MajdAzzamx1/Test1/WRO GitHub/V1/models/3D printers/Room.jpeg

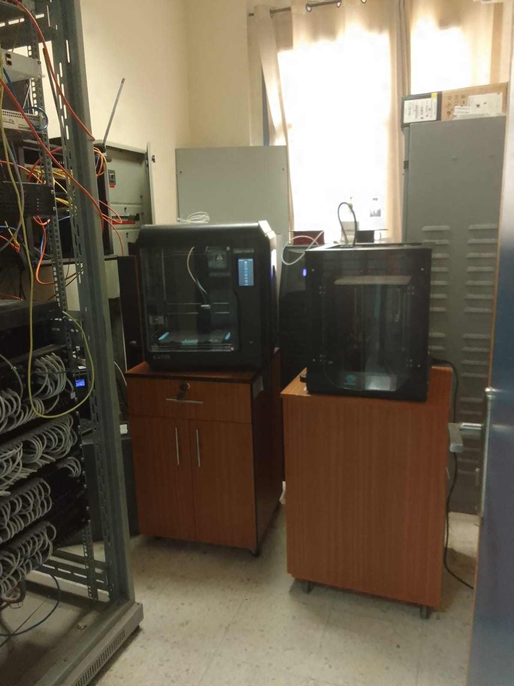
WRO GitHub/V1/models/3D printers/Room.jpeg
