MajdAzzamx1/Test1/WRO GitHub/V1/models/3D design/CASEAR Design.pdf

# CAESAR DESIGNING

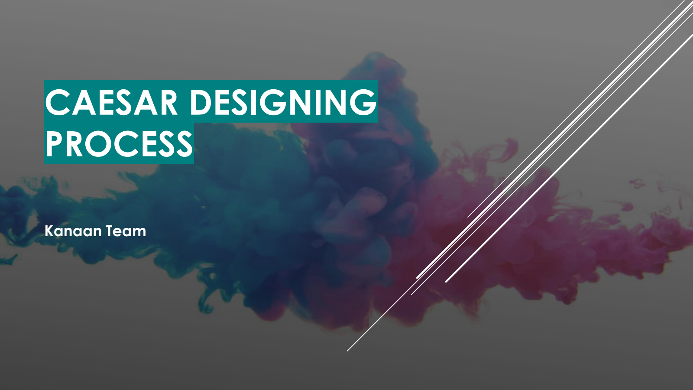
[picture p13: page 1]

# PROCESS

Kanaan Team

## DESIGN WORKFLOW

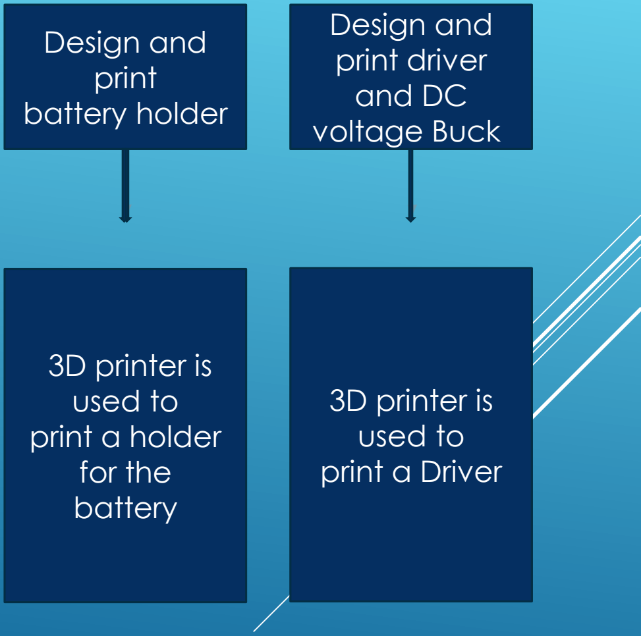
[picture p14: figure]
Design and print battery holder; Design and print driver and DC voltage Buck; 3D printer is used to print a holder for the battery; 3D printer is used to print a Driver

Design, build
and print the
robot structure

Design and
print camera
and Ultrasonic
holder

Design and
print Controller

3D printer is
used to
print a holder
for the
camera and
the front,
left, and right
ultrasonic
sensors.

3D printer is
used to
print a holder
for the
ESP32

The car's body
was built in
detail to hold
the DC motor
and the Servo
motor that
drives it

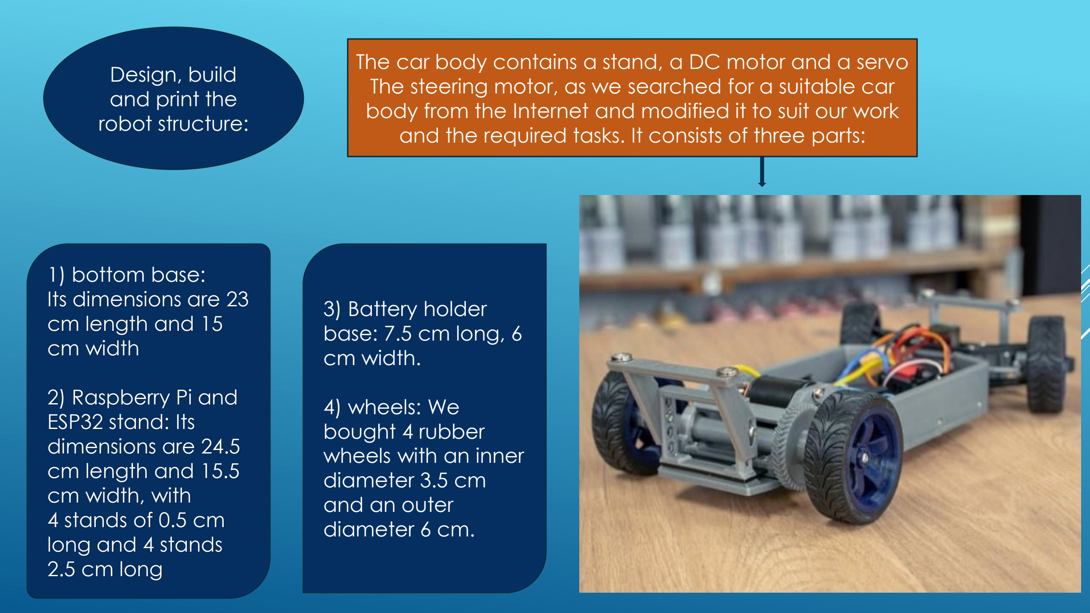
[picture p15: page 3]

Design, build
and print the
robot structure:

The car body contains a stand, a DC motor and a servo The steering motor, as we searched for a suitable car body from the Internet and modified it to suit our work and the required tasks. It consists of three parts:

1) bottom base:
Its dimensions are 23
cm length and 15
cm width
2) Raspberry Pi and
ESP32 stand: Its
dimensions are 24.5
cm length and 15.5
cm width, with
4 stands of 0.5 cm
long and 4 stands
2.5 cm long
3) Battery holder
base: 7.5 cm long, 6
cm width.
4) wheels: We
bought 4 rubber
wheels with an inner
diameter 3.5 cm
and an outer
diameter 6 cm.

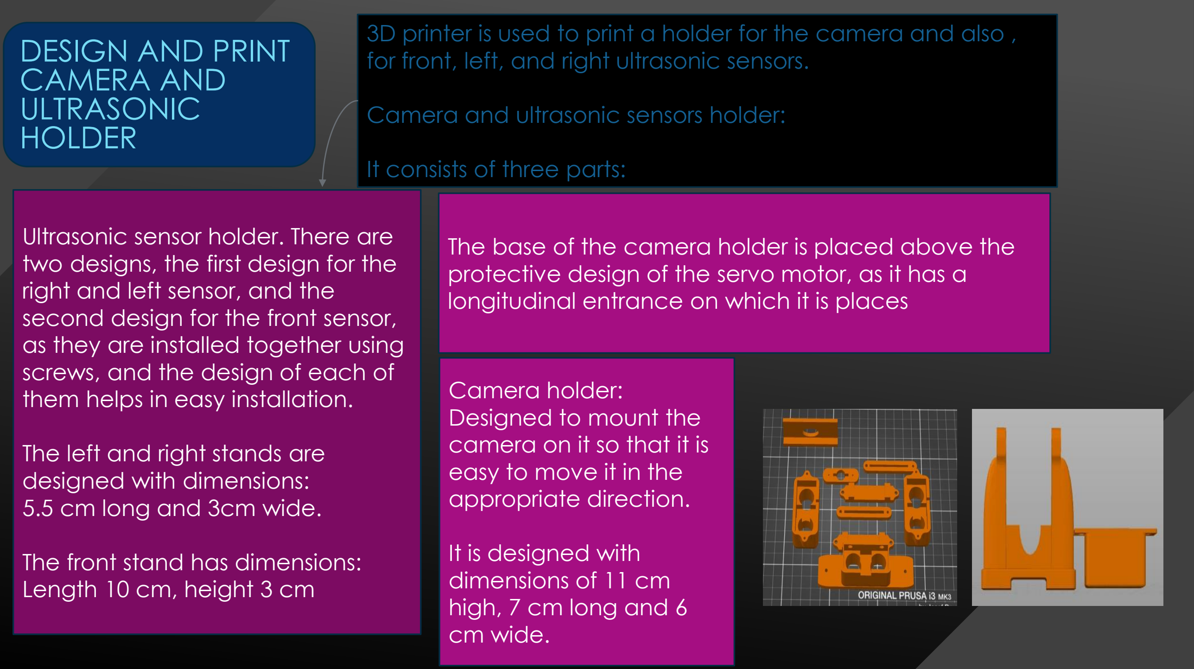
[picture p16: figure]
DESIGN AND PRINT CAMERA AND ULTRASONIC HOLDER; Camera and ultrasonic sensors holder:; It consists of three parts:; Ultrasonic sensor holder. There are two designs, the first design for the right and left sensor, and the second design for the front sensor, as they are installed together using screws, and the design of each of them helps in easy installation.; The left and right stands are designed with dimensions: 5.5 cm long and 3cm wide.; The front stand has dimensions: Length 10 cm, height 3 cm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

3D printer is used to print a holder for the camera and also , for front, left, and right ultrasonic sensors.

The base of the camera holder is placed above the protective design of the servo motor, as it has a longitudinal entrance on which it is places

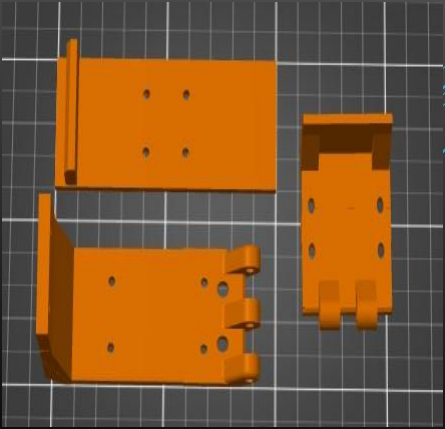
[picture p17: figure]

## DESIGN AND PRINT CONTROLLER

There is a piece on the base of the robot that contains a Raspberry Pi 4 controller, on top of which is a chassis-shaped pod that holds the Driver and ESP32.
above it. Its length is 9.5 and its width is 4.

ESP32 incubator dimensions: It is 8 cm long and 10 cm wide

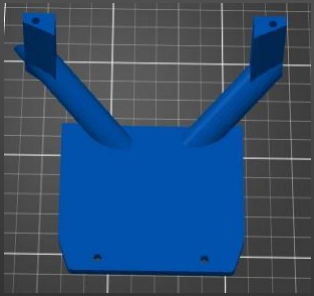
[picture p18: figure]
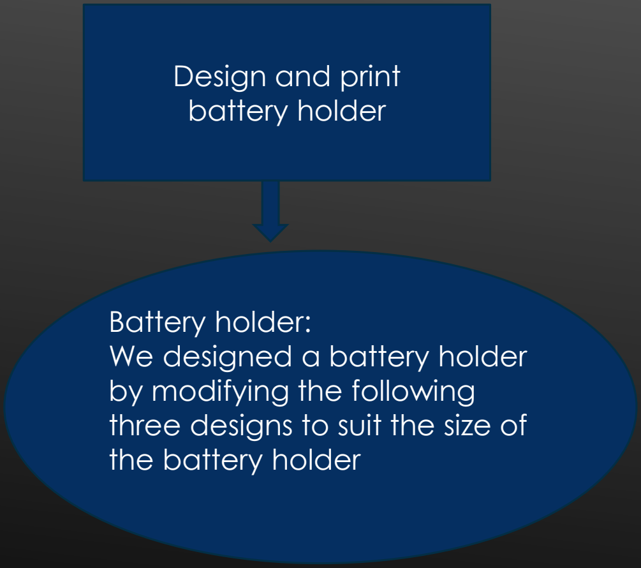
[picture p19: figure]
Design and print battery holder; Battery holder: We designed a battery holder by modifying the following three designs to suit the size of the battery holder
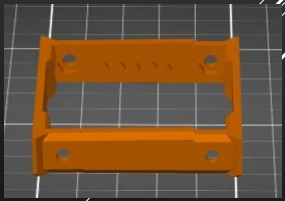
[picture p20: figure]

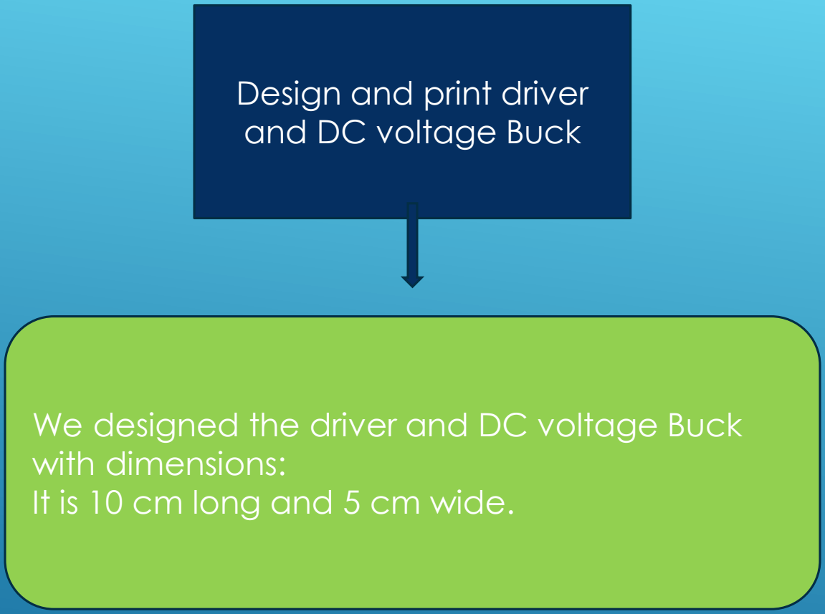
[picture p21: figure]
Design and print driver and DC voltage Buck; with dimensions: It is 10 cm long and 5 cm wide.
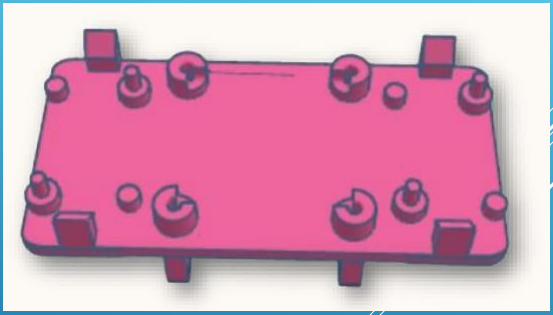
[picture p22: figure]

We designed the driver and DC voltage Buck

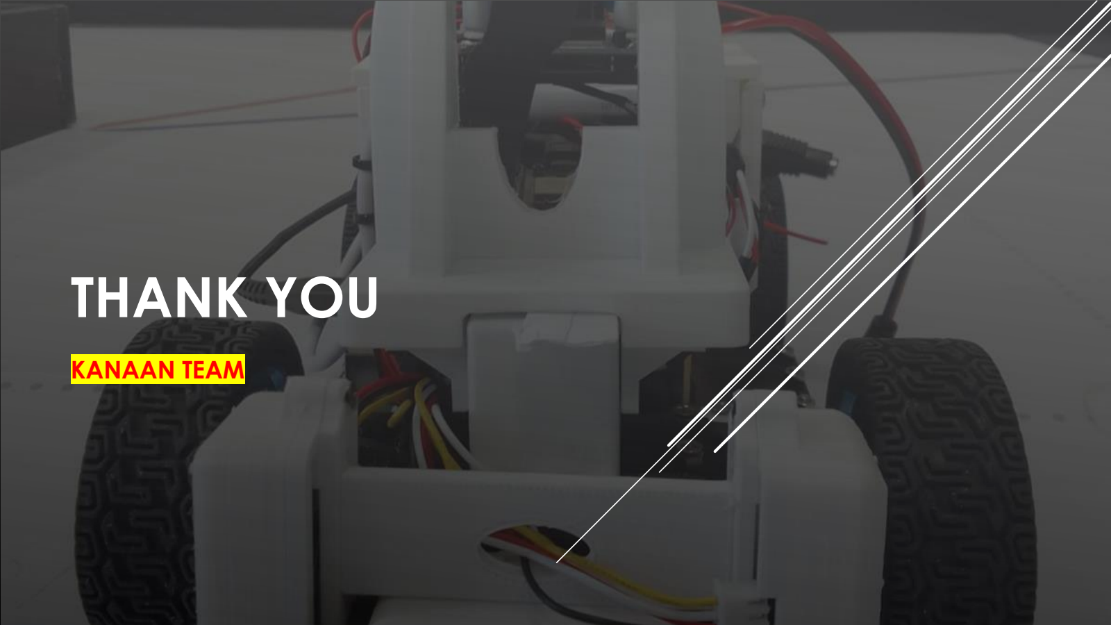
[picture p23: page 8]

# THANK YOU

KANAAN TEAM
