MajdAzzamx1/Test1/WRO GitHub/V1/schemes/Main Diagram.jpg

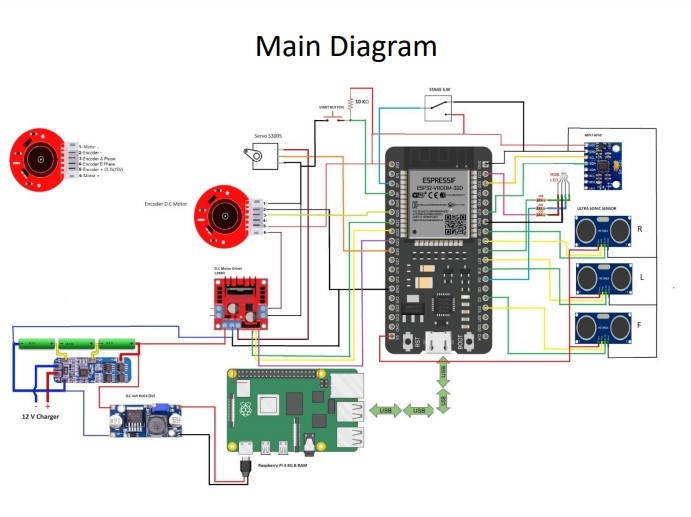
WRO GitHub/V1/schemes/Main Diagram.jpg
