MajdAzzamx1/Test1/WRO GitHub/V1/t-photo/Funny.jpeg

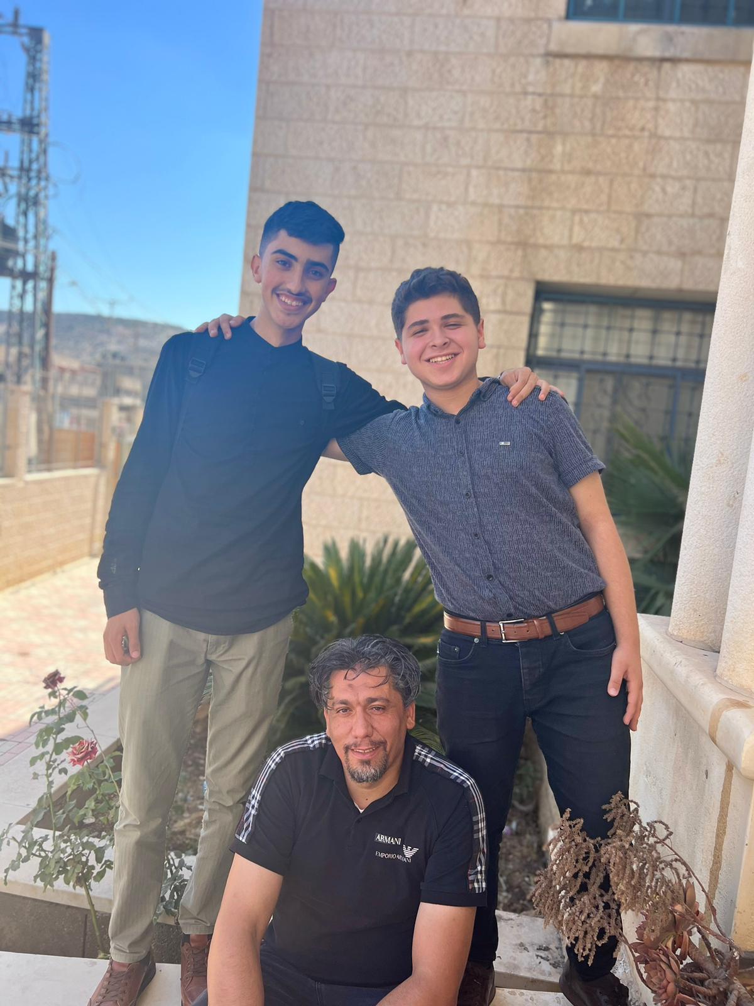
WRO GitHub/V1/t-photo/Funny.jpeg
