MajdAzzamx1/Test1/WRO GitHub/V1/t-photo/official.jpeg

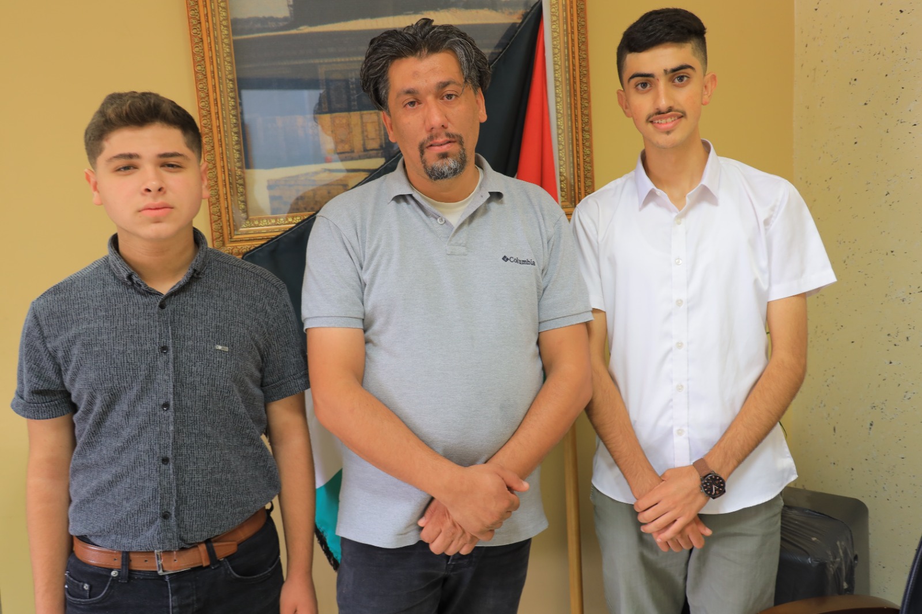
WRO GitHub/V1/t-photo/official.jpeg
