MajdAzzamx1/Test1/WRO GitHub/V1/v-photo/Back Side.jpeg

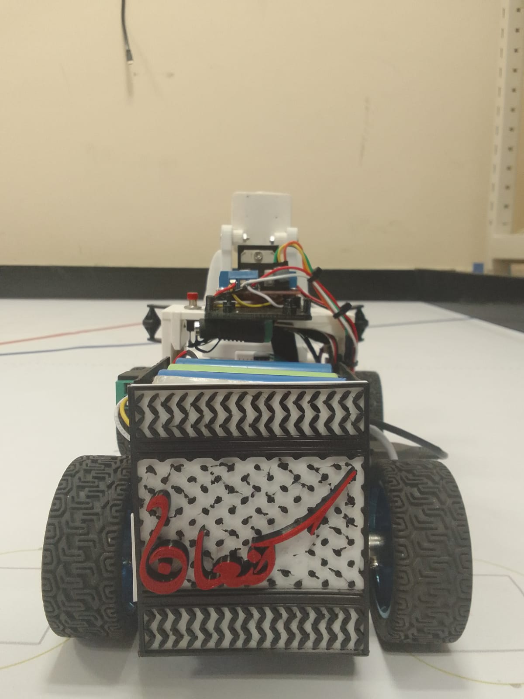
WRO GitHub/V1/v-photo/Back Side.jpeg
