MajdAzzamx1/Test1/WRO GitHub/V1/v-photo/Down Side.jpeg

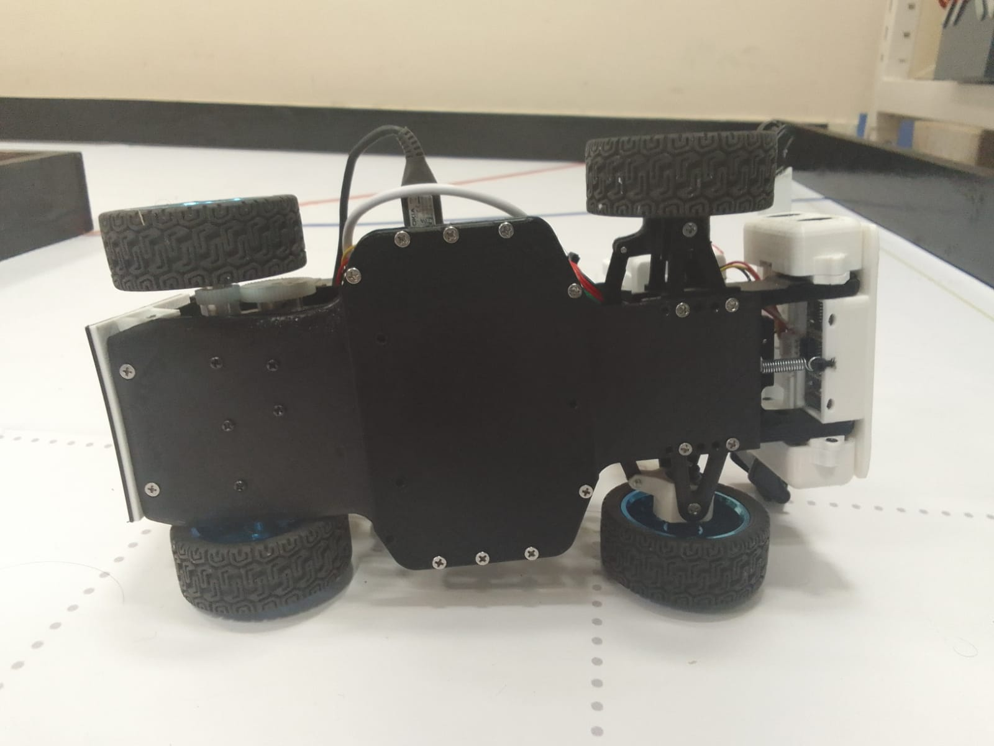
WRO GitHub/V1/v-photo/Down Side.jpeg
