MajdAzzamx1/Test1/WRO GitHub/V1/v-photo/Front Side.jpeg

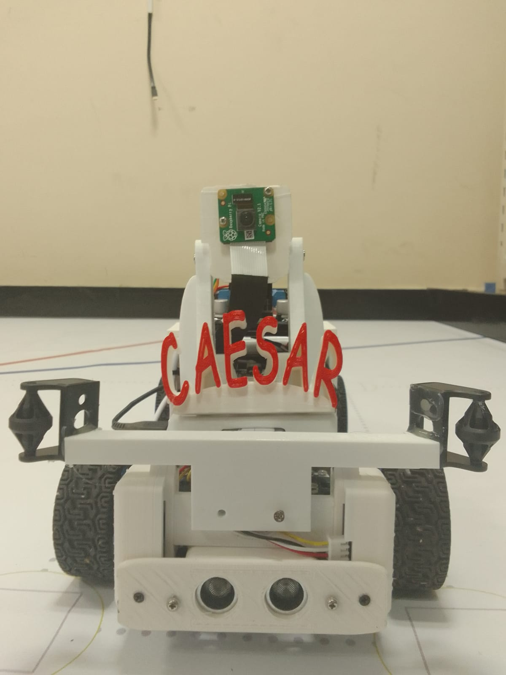
WRO GitHub/V1/v-photo/Front Side.jpeg
