MajdAzzamx1/Test1/WRO GitHub/V1/v-photo/Top Side/Top Side1.jpeg

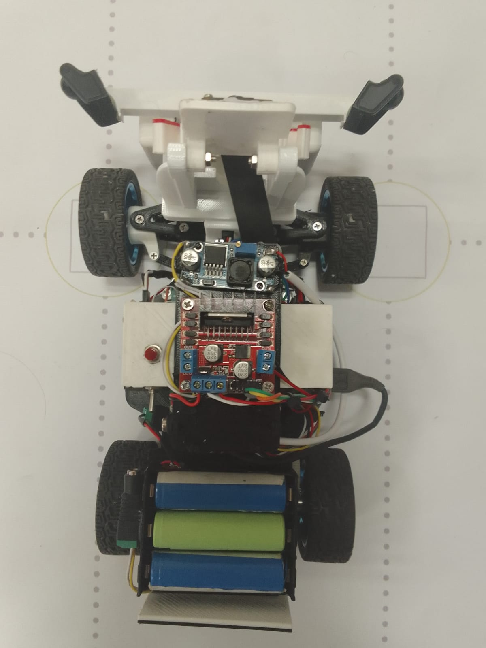
WRO GitHub/V1/v-photo/Top Side/Top Side1.jpeg
