MajdAzzamx1/Test1/WRO GitHub/3d/Rear_Flex_2.stl

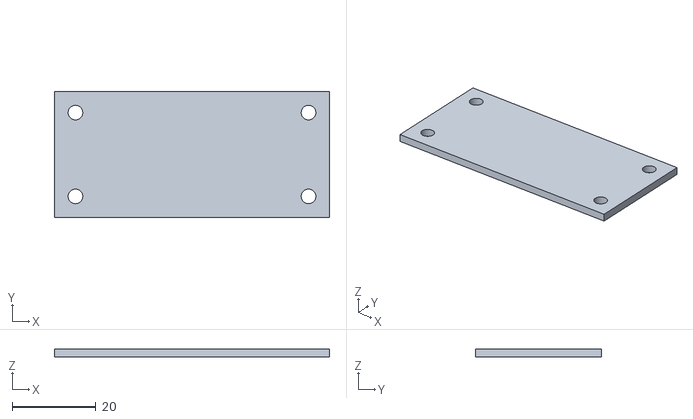
[picture p57: CAD file, 2023-10-11]
WRO GitHub/3d/Rear_Flex_2.stl
65.6 x 30.0 x 2.00
