MajdAzzamx1/Test1/WRO GitHub/3d/Chassis_1.stl

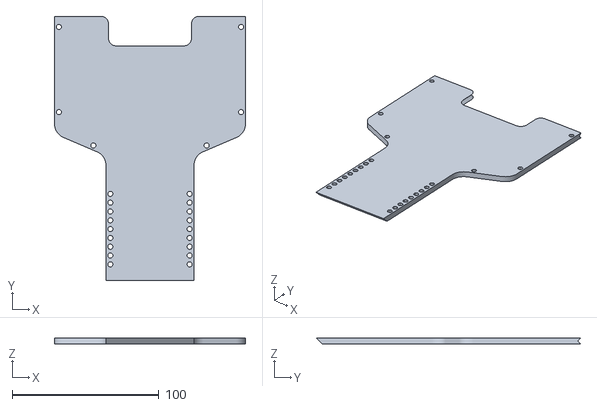
[picture p58: CAD file, 2023-10-11]
WRO GitHub/3d/Chassis_1.stl
130.0 x 179.7 x 4.00
