MajdAzzamx1/Test1/WRO GitHub/V1/models/3D printed designs/STEERINGWEELADAPTER.stl

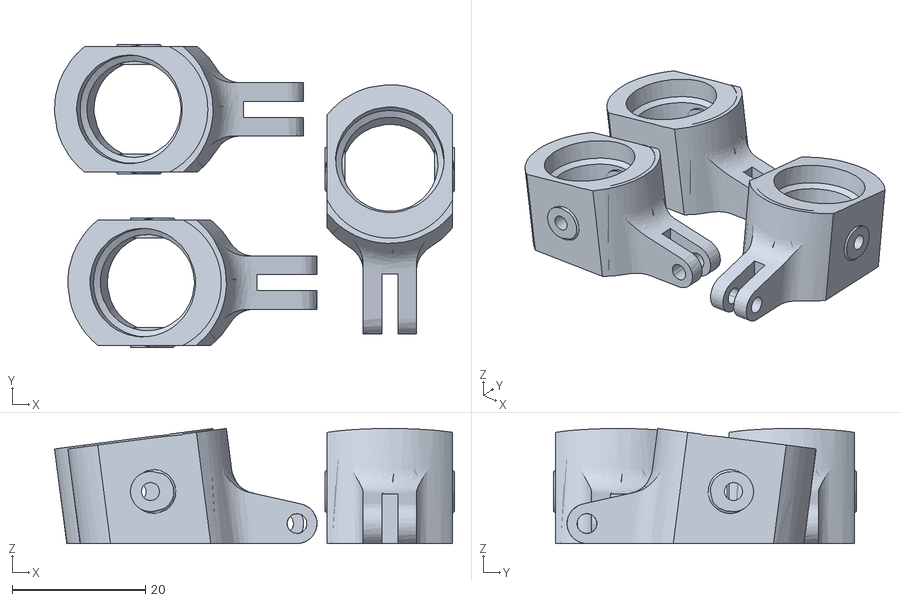
[picture p59: CAD file, 2023-10-11]
WRO GitHub/V1/models/3D printed designs/STEERINGWEELADAPTER.stl
60.0 x 45.4 x 17.3
