MajdAzzamx1/Test1/WRO GitHub/3d/B_Front_Frame.stl

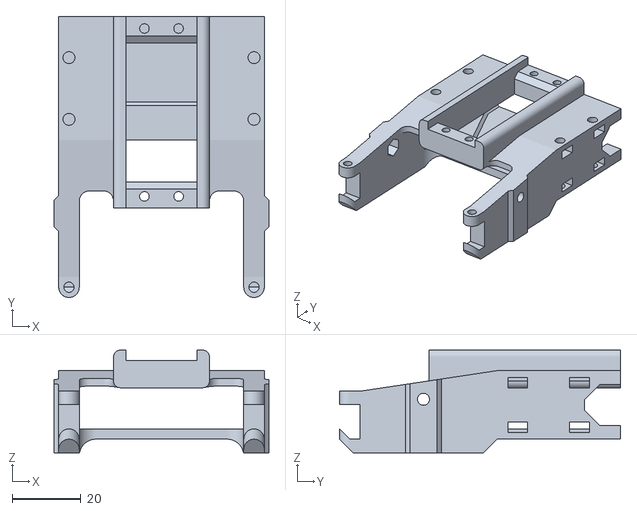
[picture p60: CAD file, 2023-10-11]
WRO GitHub/3d/B_Front_Frame.stl
62.6 x 82.0 x 30.0
