MajdAzzamx1/Test1/WRO GitHub/V1/models/3D printed designs/Case_Holder.stl

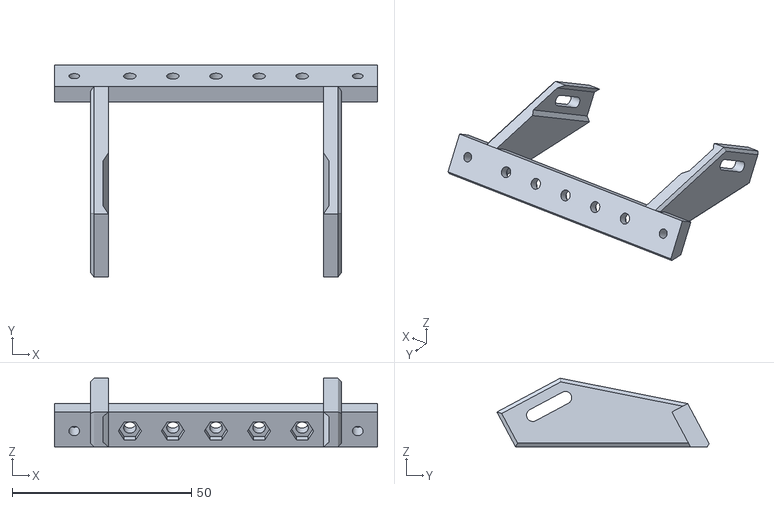
[picture p61: CAD file, 2023-10-11]
WRO GitHub/V1/models/3D printed designs/Case_Holder.stl
90.0 x 59.2 x 19.1
