MajdAzzamx1/Test1/WRO GitHub/3d/Wheel_Axis.stl

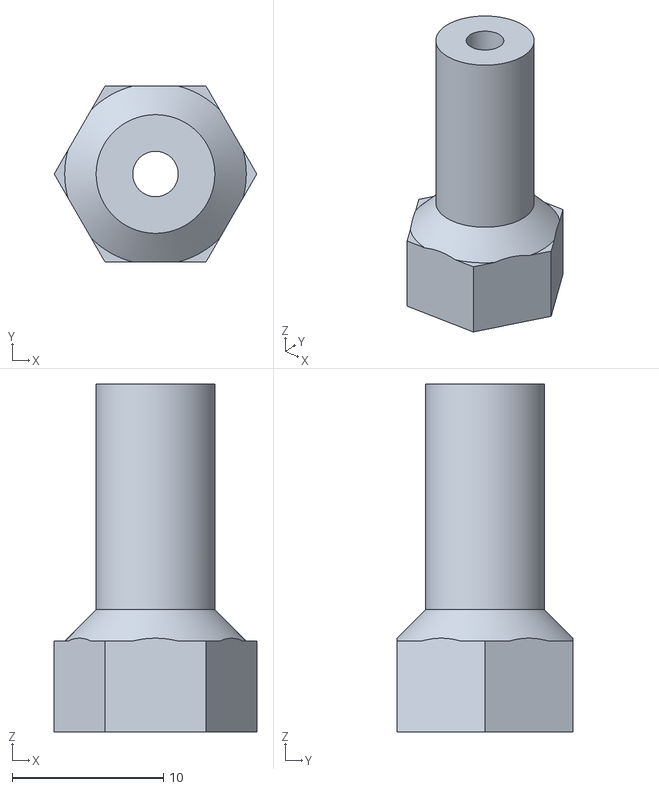
[picture p62: CAD file, 2023-10-11]
WRO GitHub/3d/Wheel_Axis.stl
13.4 x 11.6 x 23.0
