MajdAzzamx1/Test1/WRO GitHub/V1/models/3D printed designs/processing (1).stl

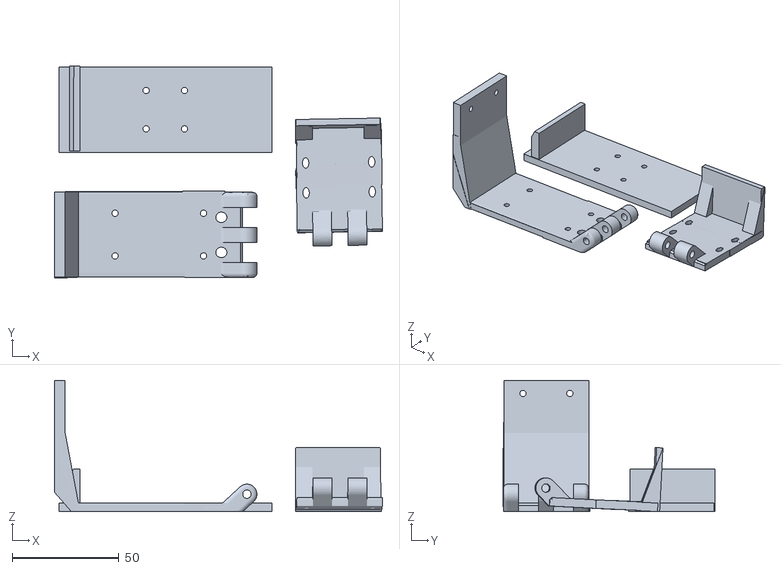
[picture p63: CAD file, 2023-10-11]
WRO GitHub/V1/models/3D printed designs/processing (1).stl
153.9 x 99.5 x 61.7
