MajdAzzamx1/Test1/WRO GitHub/V1/models/3D printed designs/Smooth Waasa.stl

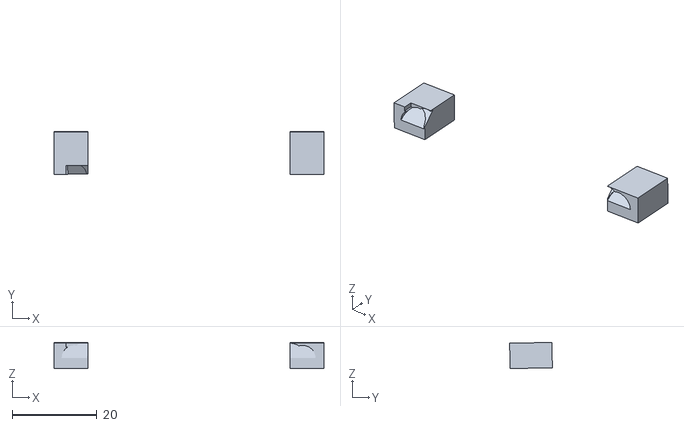
[picture p65: CAD file, 2023-10-11]
WRO GitHub/V1/models/3D printed designs/Smooth Waasa.stl
63.8 x 10.1 x 6.17
