MajdAzzamx1/Test1/WRO GitHub/3d/Chassis_2.stl

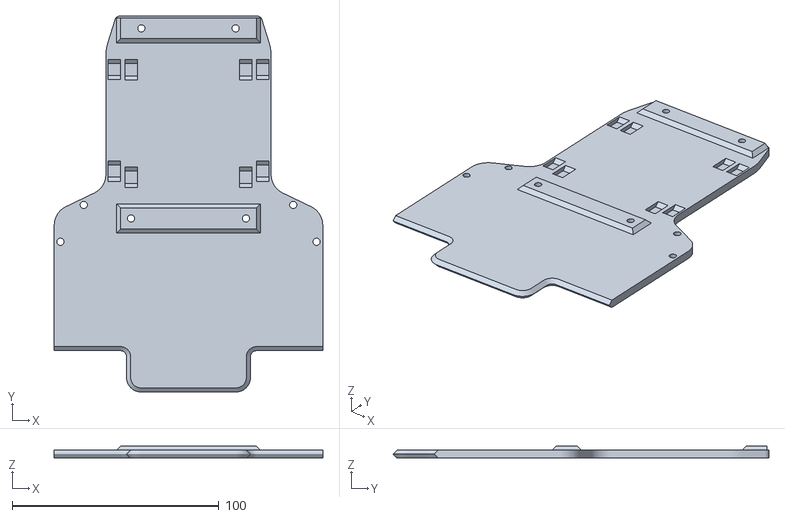
[picture p66: CAD file, 2023-10-11]
WRO GitHub/3d/Chassis_2.stl
130.0 x 182.0 x 6.00
