MajdAzzamx1/Test1/WRO GitHub/V1/models/3D printed designs/Body_L.stl

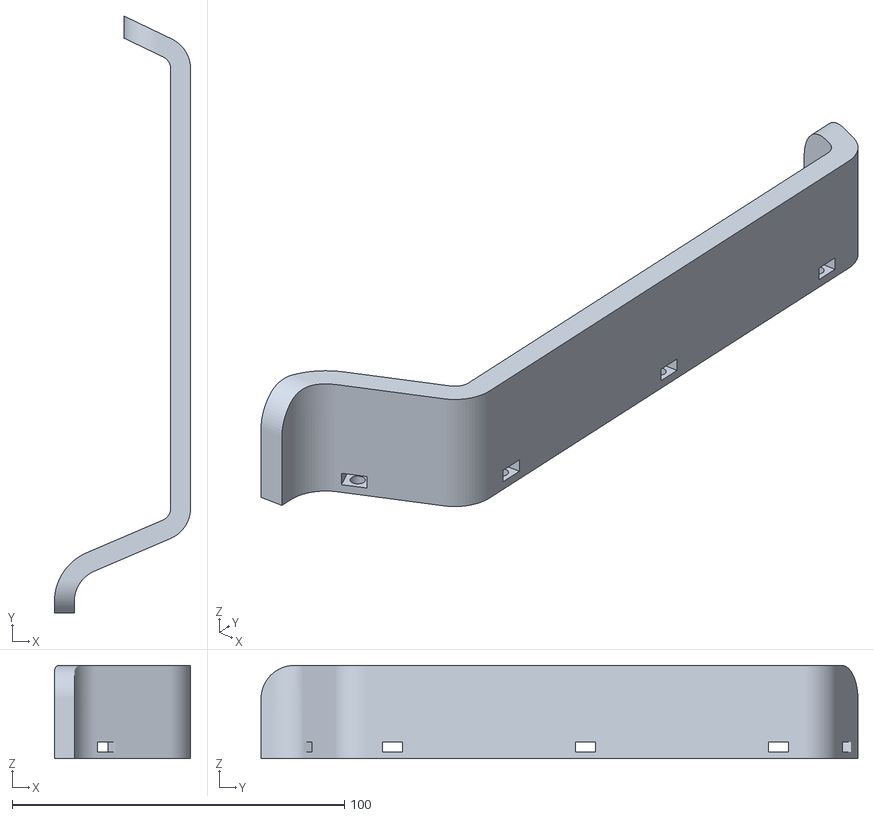
[picture p67: CAD file, 2023-10-11]
WRO GitHub/V1/models/3D printed designs/Body_L.stl
41.0 x 179.6 x 28.0
