MajdAzzamx1/Test1/WRO GitHub/V1/models/3D printed designs/ServoSlider2.stl

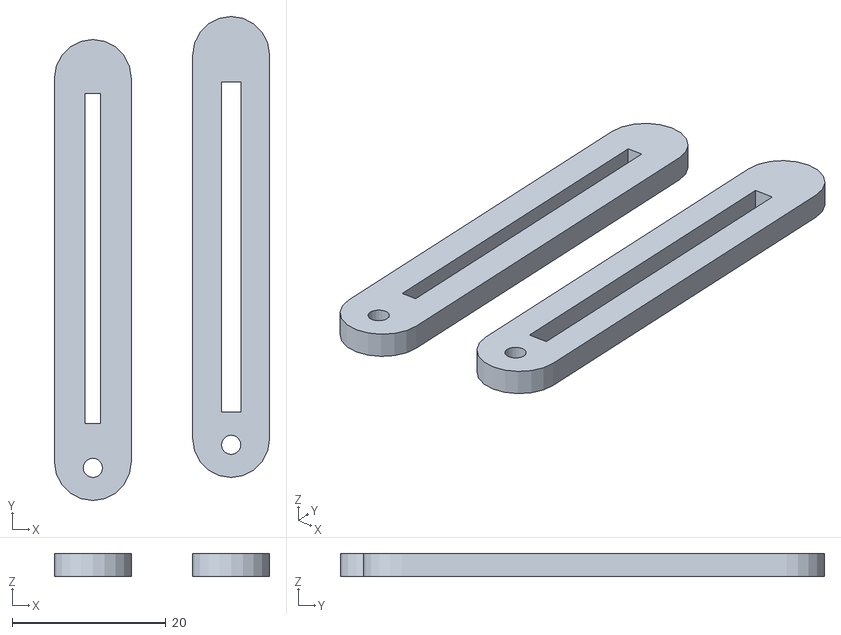
[picture p68: CAD file, 2023-10-11]
WRO GitHub/V1/models/3D printed designs/ServoSlider2.stl
28.0 x 63.0 x 3.00
