MajdAzzamx1/Test1/WRO GitHub/V1/models/3D printed designs/ServoSlider.stl

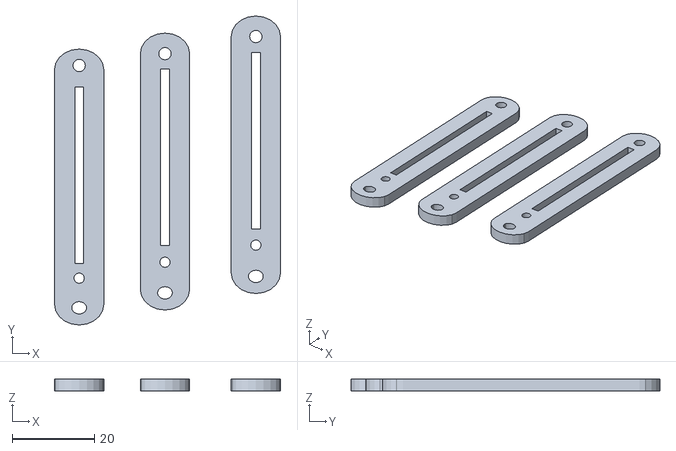
[picture p69: CAD file, 2023-10-11]
WRO GitHub/V1/models/3D printed designs/ServoSlider.stl
55.0 x 75.2 x 3.00
