MajdAzzamx1/Test1/WRO GitHub/3d/cameraStand and servocover.stl

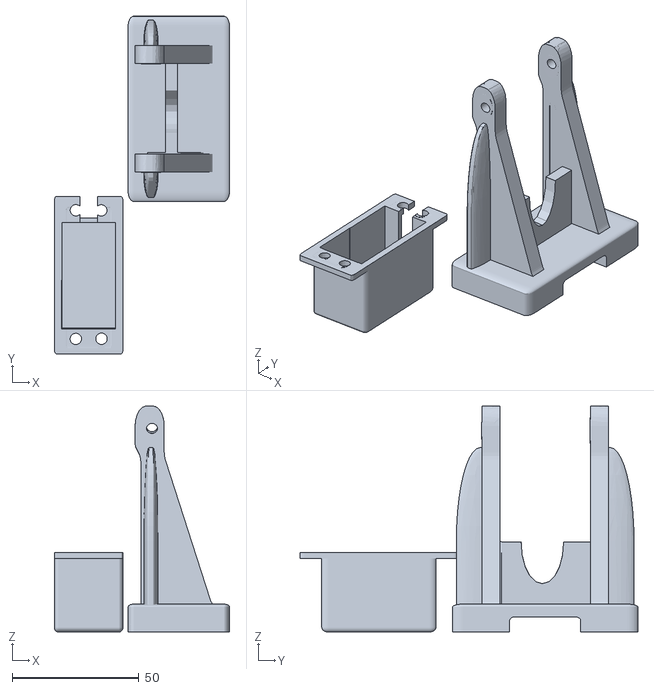
[picture p70: CAD file, 2023-10-11]
WRO GitHub/3d/cameraStand and servocover.stl
69.0 x 133.0 x 89.0
