MajdAzzamx1/Test1/WRO GitHub/V1/models/3D printed designs/Battary Holder1.stl

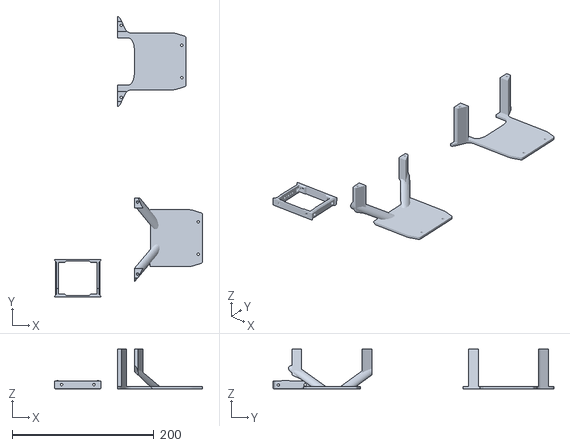
[picture p71: CAD file, 2023-10-11]
WRO GitHub/V1/models/3D printed designs/Battary Holder1.stl
208.6 x 395.9 x 56.1
