MajdAzzamx1/Test1/WRO GitHub/V1/models/3D printed designs/TeamName (1).stl

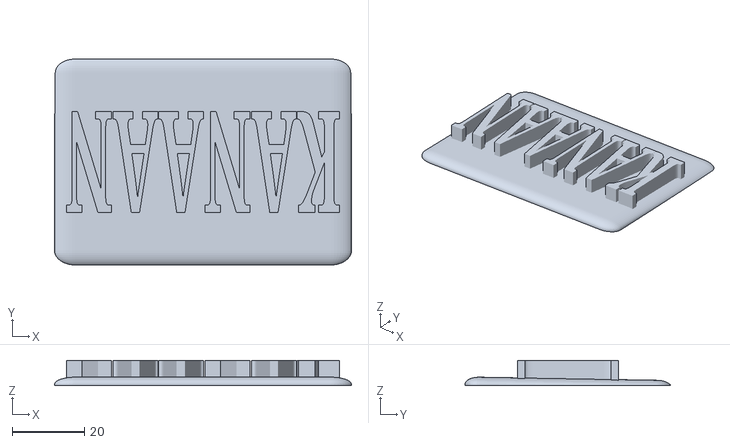
[picture p72: CAD file, 2023-10-11]
WRO GitHub/V1/models/3D printed designs/TeamName (1).stl
82.0 x 56.8 x 7.00
