MajdAzzamx1/Test1/WRO GitHub/V1/models/3D printed designs/battary holder.stl

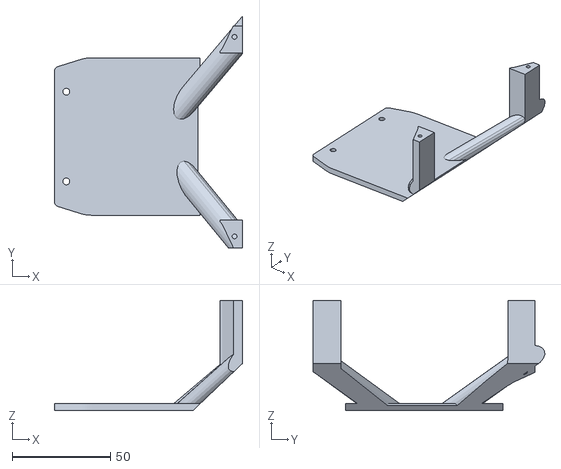
[picture p73: CAD file, 2023-10-11]
WRO GitHub/V1/models/3D printed designs/battary holder.stl
95.5 x 117.8 x 56.1
