MajdAzzamx1/Test1/WRO GitHub/V1/models/3D printed designs/kofeia.stl

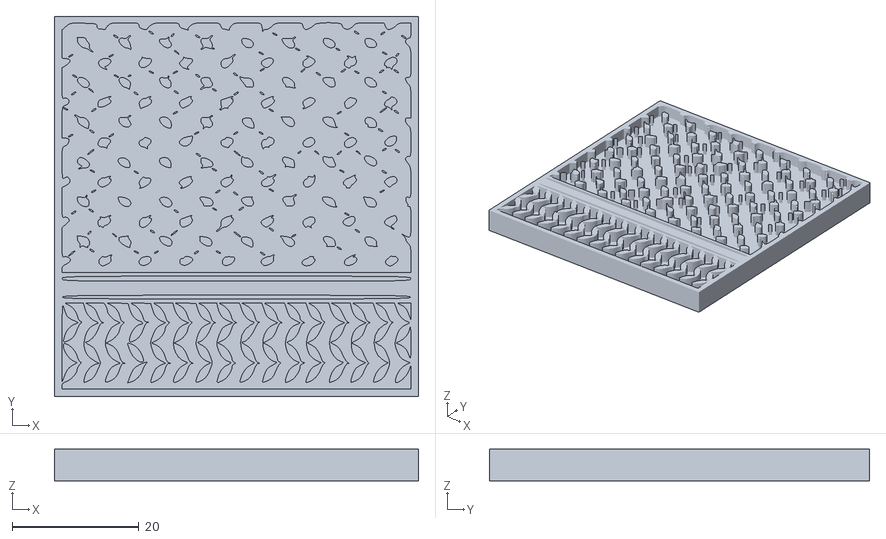
[picture p74: CAD file, 2023-10-11]
WRO GitHub/V1/models/3D printed designs/kofeia.stl
57.5 x 60.0 x 5.00
