MajdAzzamx1/Test1/WRO GitHub/V1/models/3D printed designs/ultrasonicHolder.stl

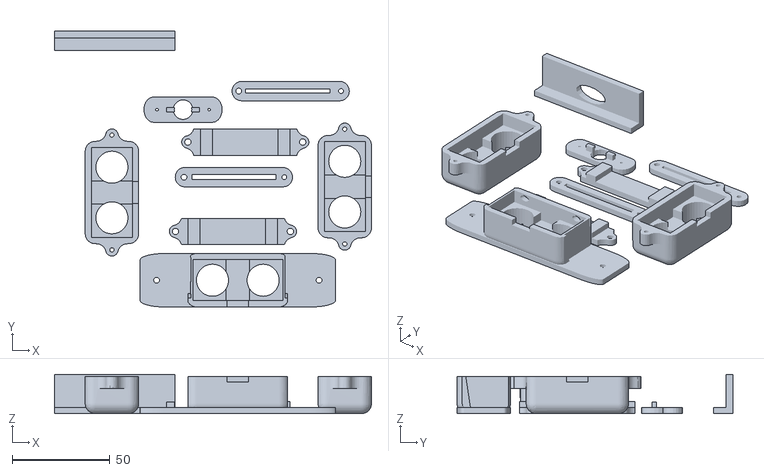
[picture p75: CAD file, 2023-10-11]
WRO GitHub/V1/models/3D printed designs/ultrasonicHolder.stl
162.0 x 141.0 x 20.0
