MajdAzzamx1/Test1/WRO GitHub/V1/models/3D printed designs/ultraBack.stl

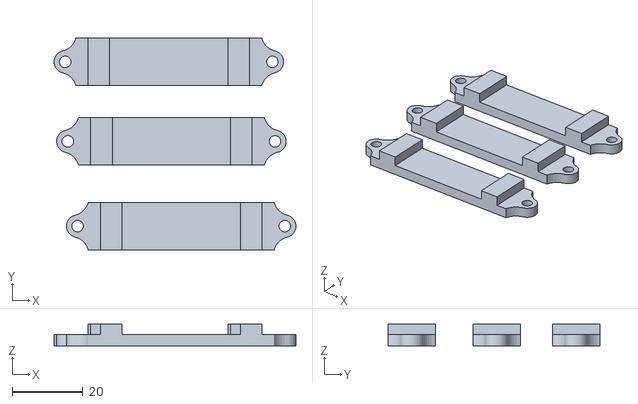
[picture p76: CAD file, 2023-10-11]
WRO GitHub/V1/models/3D printed designs/ultraBack.stl
68.5 x 60.0 x 6.17
