MajdAzzamx1/Test1/WRO GitHub/V1/models/3D printed designs/TeamLogo.stl

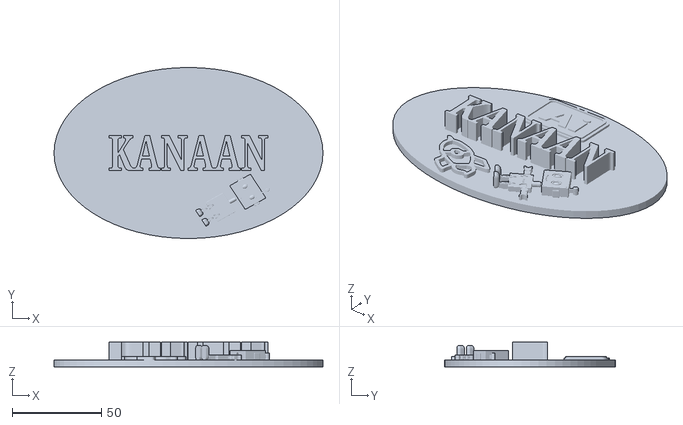
[picture p77: CAD file, 2023-10-11]
WRO GitHub/V1/models/3D printed designs/TeamLogo.stl
151.0 x 96.0 x 14.0
