MajdAzzamx1/Test1/WRO GitHub/V1/models/3D printed designs/small stearing.stl

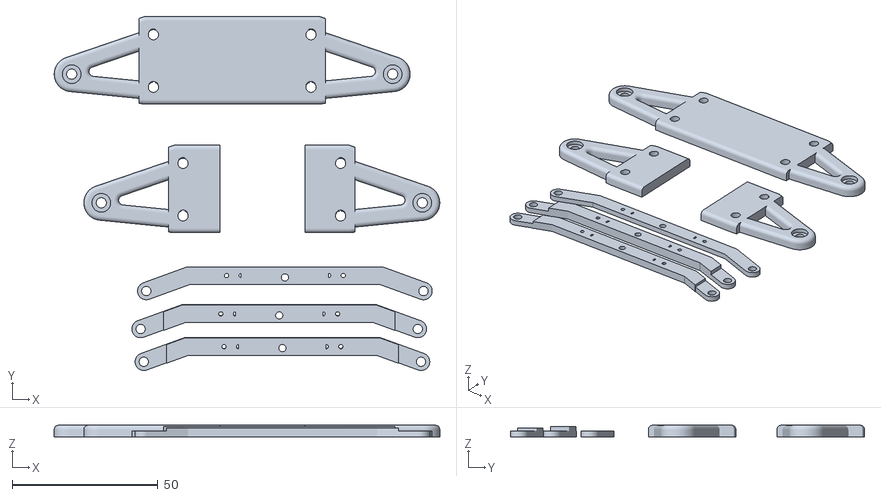
[picture p78: CAD file, 2023-10-11]
WRO GitHub/V1/models/3D printed designs/small stearing.stl
132.1 x 121.3 x 4.00
