MajdAzzamx1/Test1/WRO GitHub/V1/models/3D printed designs/LevelKeyholder.stl

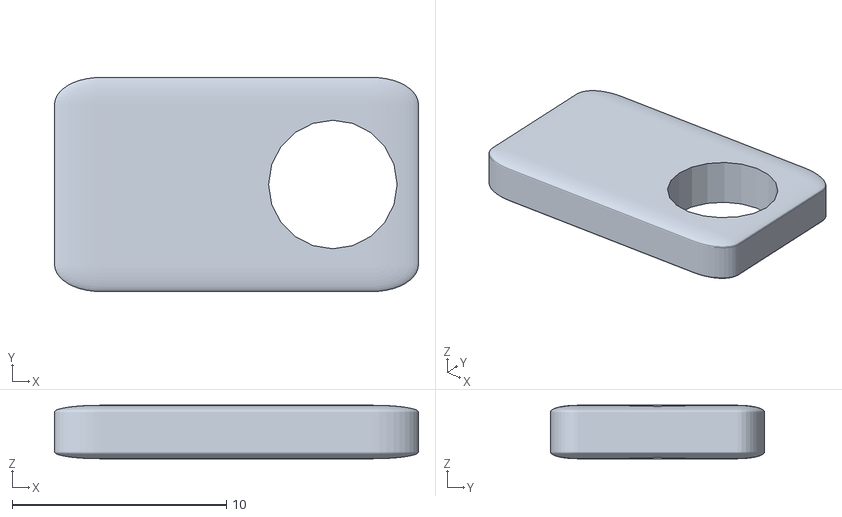
[picture p79: CAD file, 2023-10-11]
WRO GitHub/V1/models/3D printed designs/LevelKeyholder.stl
17.0 x 10.0 x 2.50
