MajdAzzamx1/Test1/(list of files, cad)

Other CAD files:
WRO GitHub/V1/models/3D printed designs/cameraStand and servocover.stl
WRO GitHub/3d/Basic_Wheel_01_Nut.stl
WRO GitHub/3d/Wheel_Axis_Nut.stl
WRO GitHub/V1/models/3D printed designs/Basic_Wheel_01_Nut.stl
WRO GitHub/V1/models/3D printed designs/Servo holder (2).stl
WRO GitHub/V1/models/3D printed designs/Wheel_Axis_Nut.stl
WRO GitHub/V1/models/3D printed designs/battary holder (2).stl
