MajdAzzamx1/Test1/WRO GitHub/V1/models/3D printers/3D printer1.jpeg

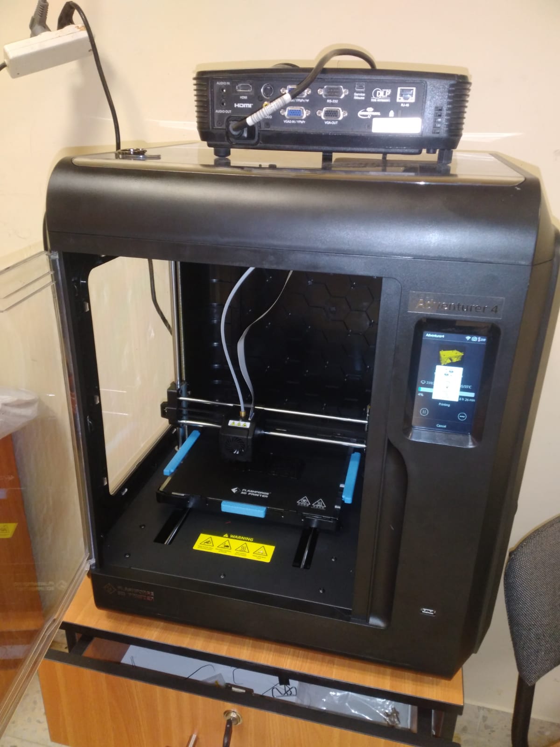
WRO GitHub/V1/models/3D printers/3D printer1.jpeg
